DARKB100D/ESPTelegramPCSwitch/schemes/Label.bmp

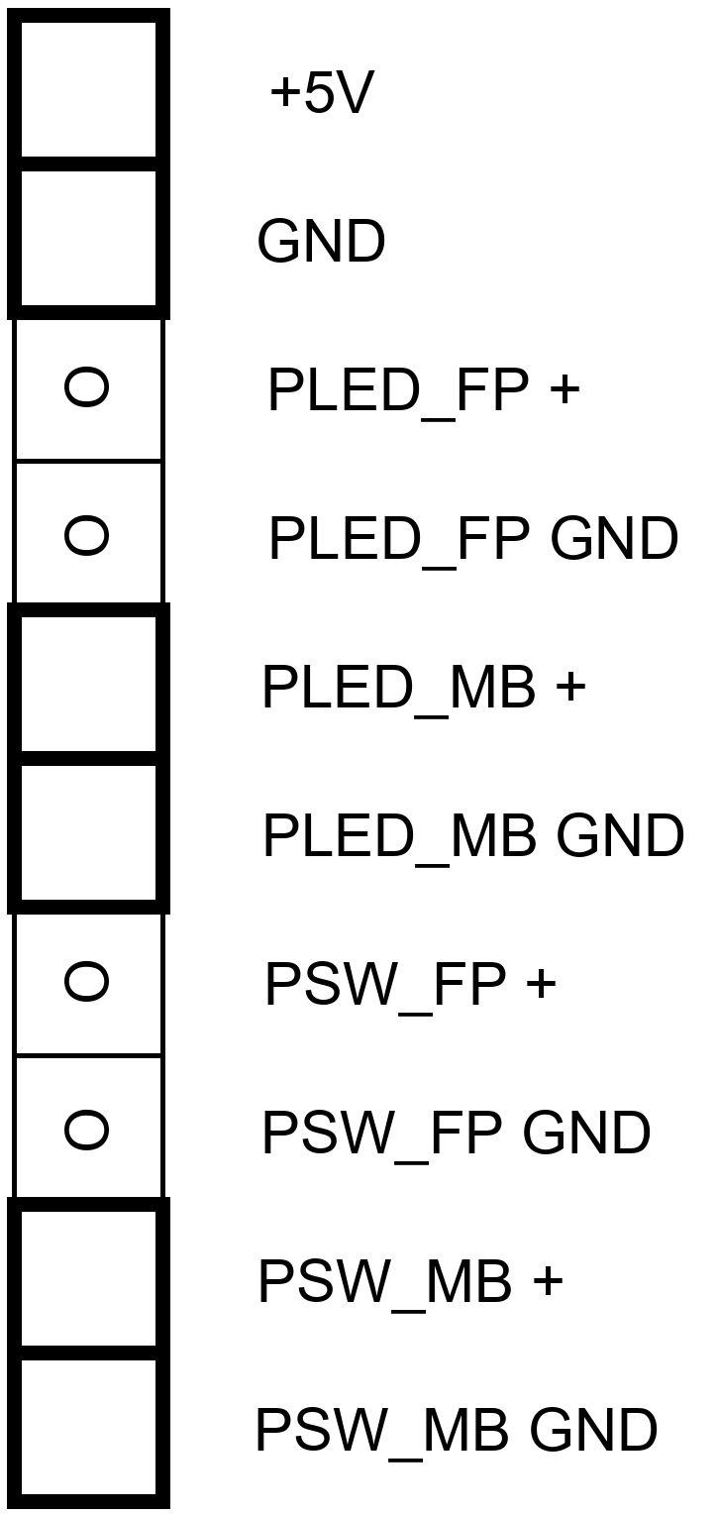
schemes/Label.bmp
