DARKB100D/ESPTelegramPCSwitch/schemes/Schematic_ESP-WoL.pdf

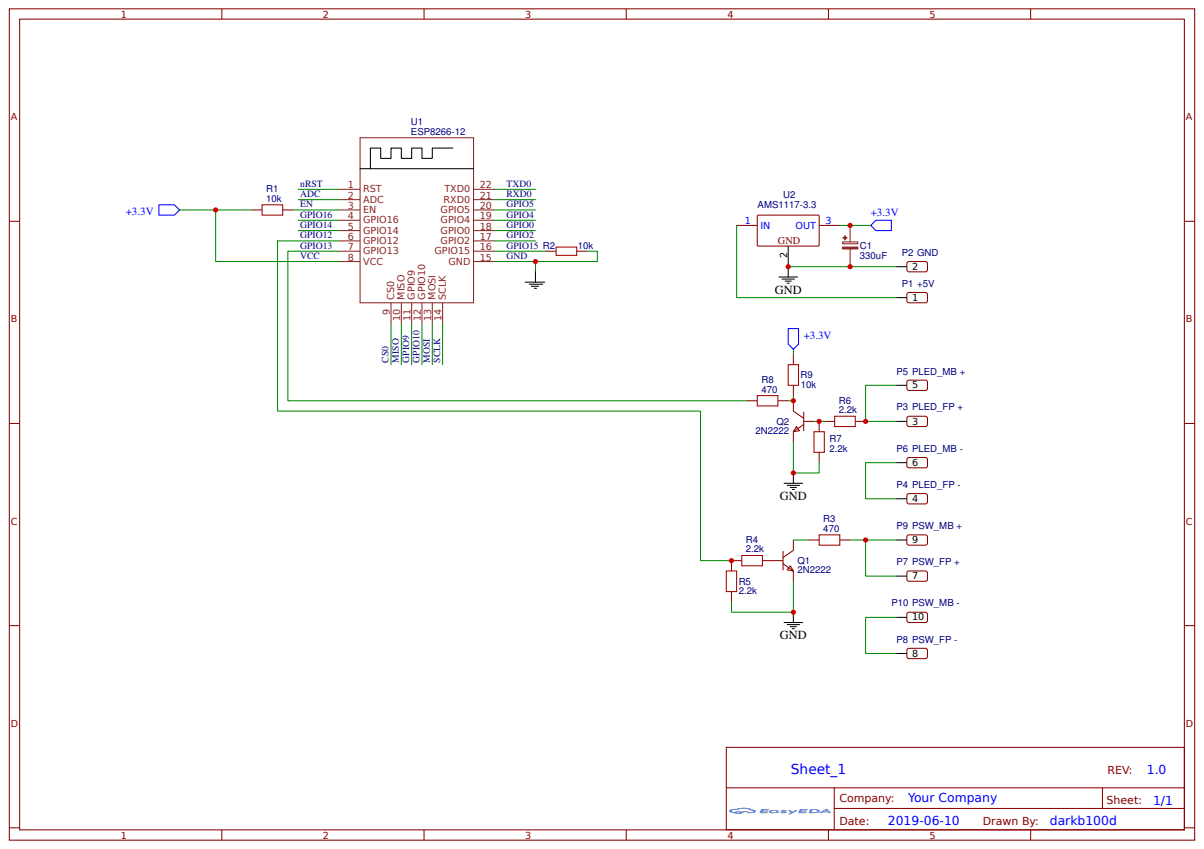
[picture p7: page 1]
