DARKB100D/ESPTelegramPCSwitch/(commit log)

2019-06-16 Invert SW pin
2019-06-16 Revert "add init message"
    This reverts commit d6b2efa994a5f8f83f47f7f11e524fa420011e47.
    [wol.ino]
2021-09-18 Update Universal Arduino Telegram Bot from 1.1.0 to 1.3.0
